elektrowizards/Virtueller_Sicherheitsbereich_fuer_Fahrradfahrer/bild/offset_3.jpeg

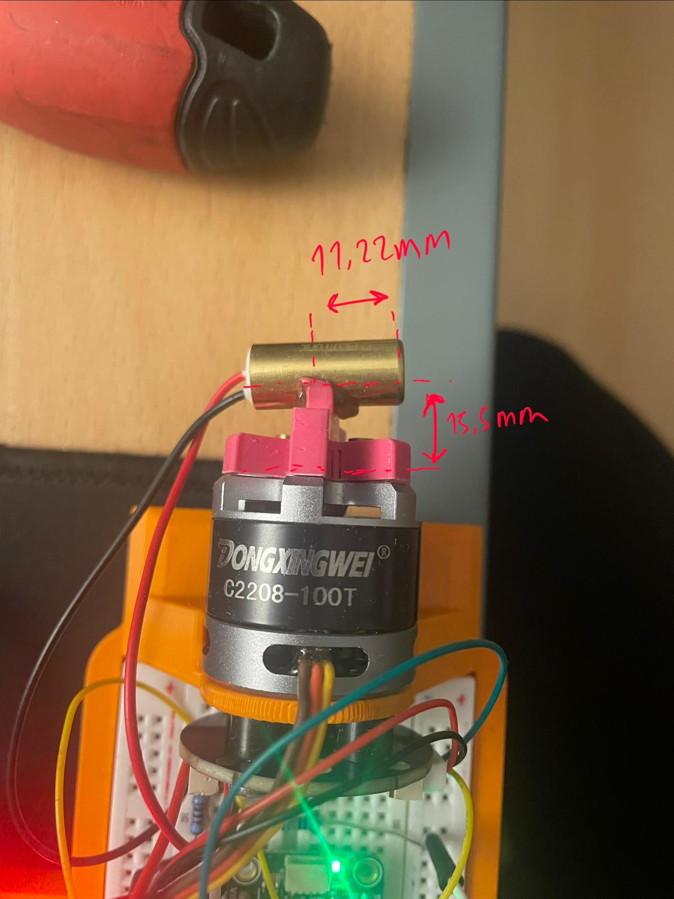
bild/offset_3.jpeg
