elektrowizards/Virtueller_Sicherheitsbereich_fuer_Fahrradfahrer/bild/offset_2.jpeg

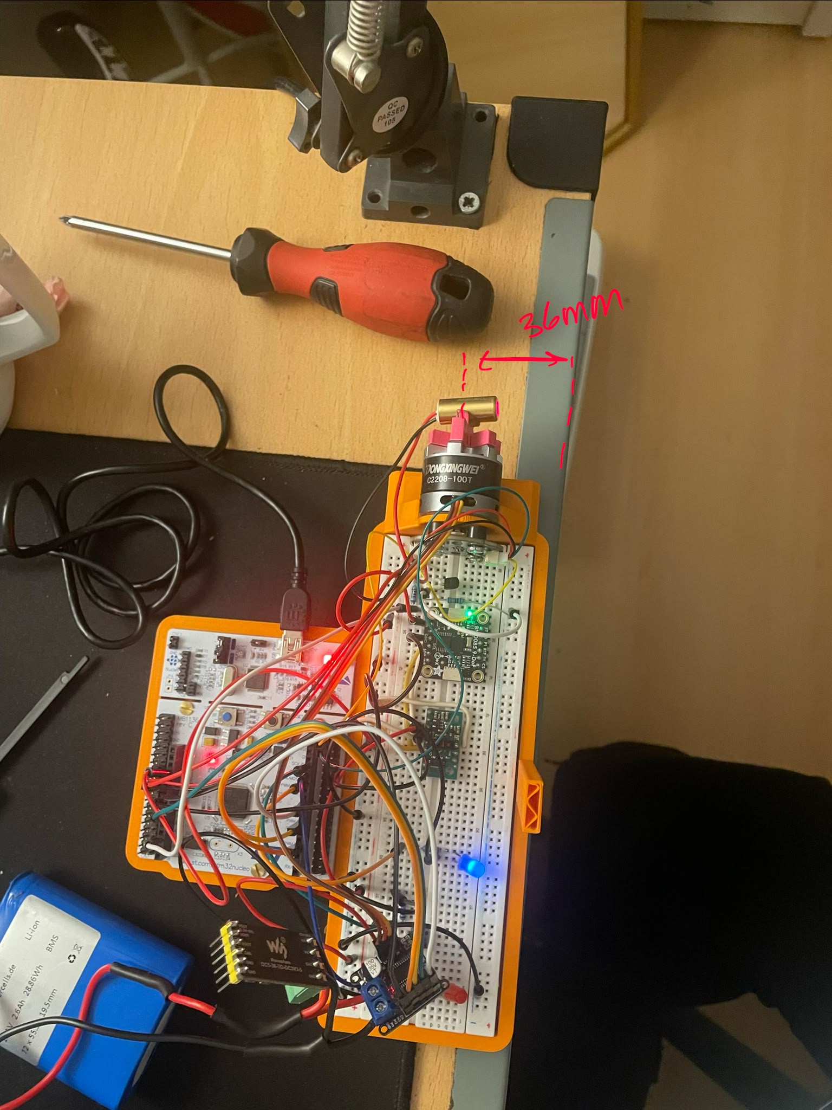
bild/offset_2.jpeg
