elektrowizards/Virtueller_Sicherheitsbereich_fuer_Fahrradfahrer/bild/offset_1.jpeg

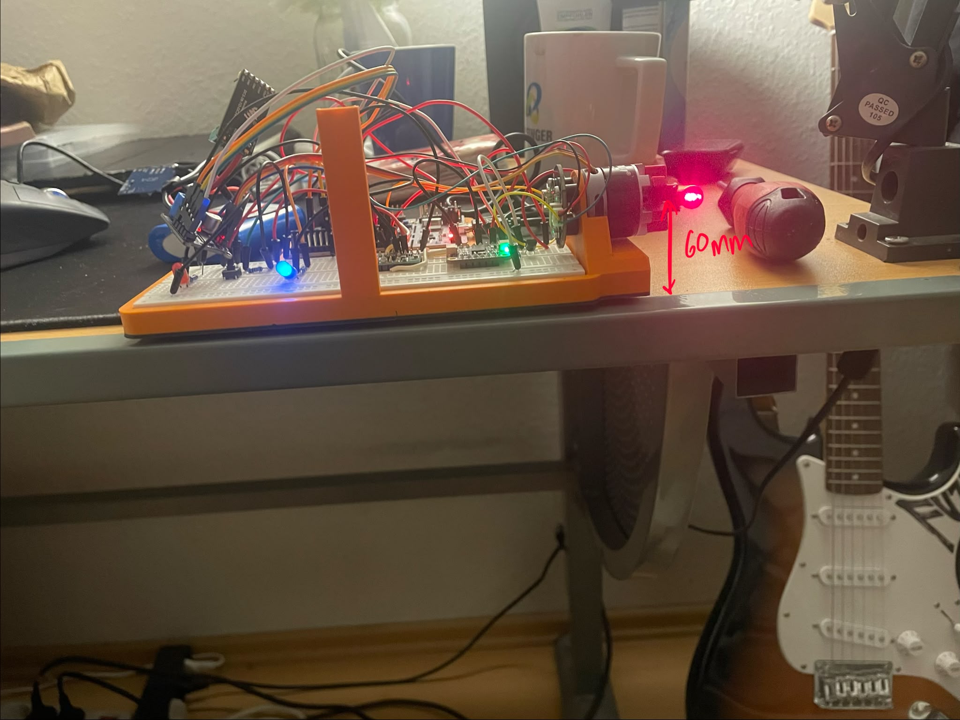
bild/offset_1.jpeg
