elektrowizards/Virtueller_Sicherheitsbereich_fuer_Fahrradfahrer/3D_design/gehäuse_board.FCStd

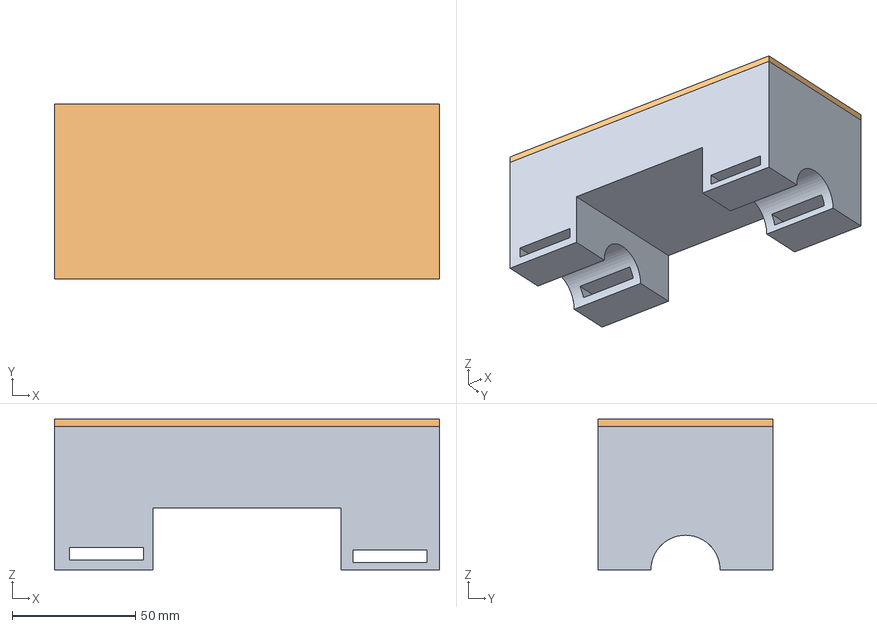
[picture p4: CAD file, 2026-11-11]
3D_design/gehäuse_board.FCStd
156.0 x 71.0 x 61.0 mm
main
tutup
