elektrowizards/Virtueller_Sicherheitsbereich_fuer_Fahrradfahrer/firmware_BA-testing_with laser driver/3D_design/Gehäuse-Body.3mf

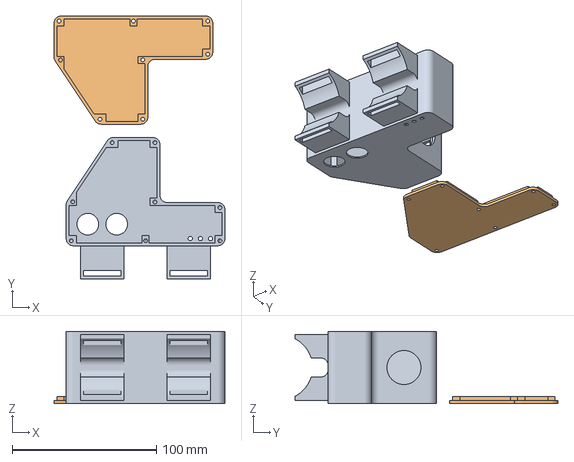
[picture p5: CAD file, 2026-11-11]
firmware_BA-testing_with laser driver/3D_design/Gehäuse-Body.3mf
118.4 x 182.2 x 50.0 mm
Gehäuse-Body
Gehäuse-cap
