elektrowizards/Virtueller_Sicherheitsbereich_fuer_Fahrradfahrer/firmware_BA-testing_with laser driver/hardware/SimpleFOCMini-1.0/3D model/OBJ_simplefocmini.obj

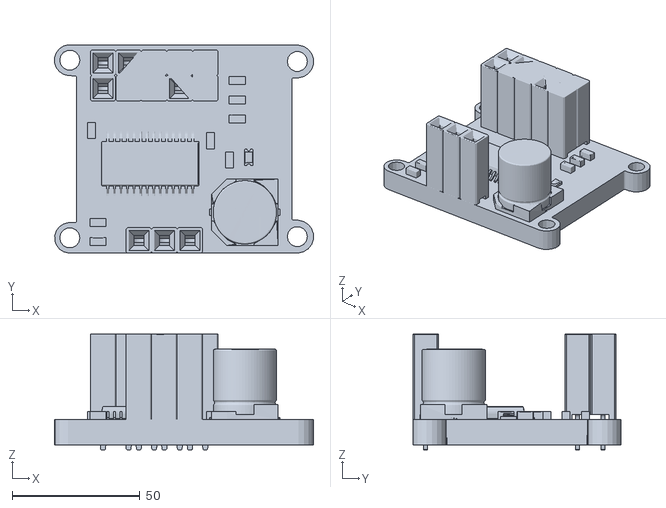
[picture p6: CAD file, 2026-11-11]
firmware_BA-testing_with laser driver/hardware/SimpleFOCMini-1.0/3D model/OBJ_simplefocmini.obj
101.3 x 81.5 x 45.3
