elektrowizards/Virtueller_Sicherheitsbereich_fuer_Fahrradfahrer/PCB_design/PCB_STM32_custom_board/final_pcb_design/board.step

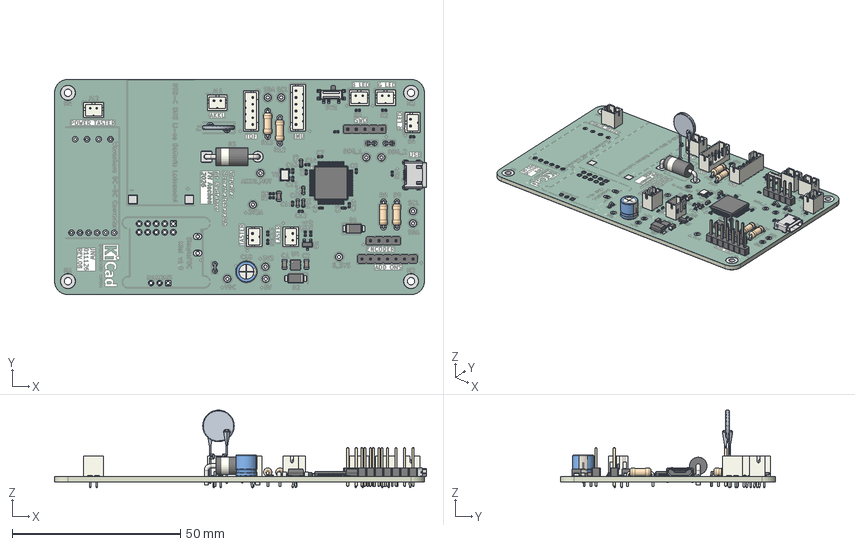
[picture p7: CAD file, 2026-11-11]
PCB_design/PCB_STM32_custom_board/final_pcb_design/board.step
110.6 x 64.0 x 23.1 mm
JST_B2B_PH_K x 7
C_0402_1005Metric x 12
PinHeader_1x07_P254mm_Vertical
R_0402_1005Metric x 10
JST_B6B_PH_K
TestPoint_Bridge_Pitch2.0mm_Drill0.7mm x 3
R_Axial_DIN0207_L63mm_D25mm_P762mm_Horizontal x 4
C_0805_2012Metric x 3
DFN_6_1EP_3x3mm_Pitch1mm
C_0603_1608Metric x 3
629105150521_Housing
629105150521_Pin1 x 4
629105150521_Pin2
629105150521_Shielding2
629105150521_Shielding
MF-RHT200
PinHeader_1x05_P254mm_Vertical
D_DO-201AD_P15.24mm_Horizontal
Fusion_sp
Crystal_SMD_3225-4Pin_3.2x2.5mm
L_0603_1608Metric
CP_Radial_D63mm_P250mm
D_SMA x 2
SOT-23
PinHeader_1x04_P254mm_Vertical
LQFP-64_10x10mm_P0.5mm
JST_B5B_PH_K
PCB_STM32_custom_board_copper
PCB_STM32_custom_board_pad
PCB_STM32_custom_board_via
PCB_STM32_custom_board_silkscreen x 2
PCB_STM32_custom_board_soldermask x 2
PCB_STM32_custom_board_PCB
