elektrowizards/Virtueller_Sicherheitsbereich_fuer_Fahrradfahrer/firmware_BA-testing_with laser driver/3D_design/bracket_BLDC_motor_zumPrototype-Body.3mf

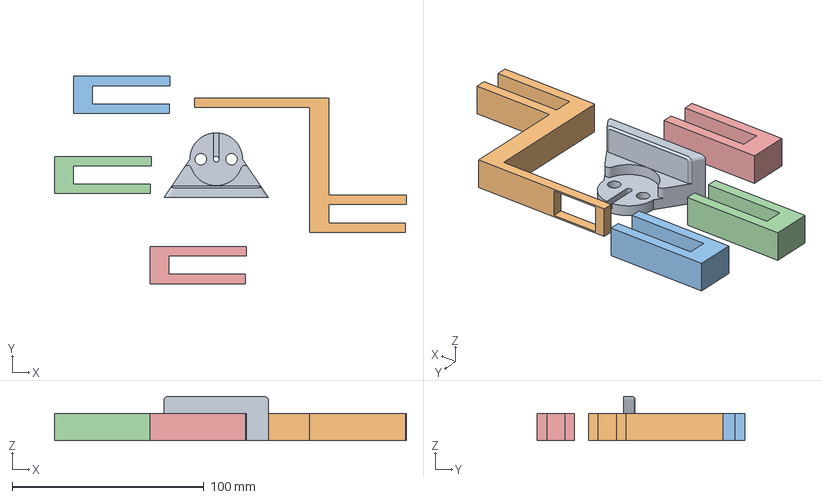
[picture p8: CAD file, 2026-11-11]
firmware_BA-testing_with laser driver/3D_design/bracket_BLDC_motor_zumPrototype-Body.3mf
183.4 x 108.1 x 23.0 mm
bracket_BLDC_motor_zumPrototype-Body
ständer_ToF_sensor-ständer_groß
ständer_ToF_sensor-ständer_klein x 3
