elektrowizards/Virtueller_Sicherheitsbereich_fuer_Fahrradfahrer/firmware_BA-testing_with laser driver/PCB_design/footprints/WE_629105150521_CAD_files/Download_IGES_629105150521 (rev1).iges

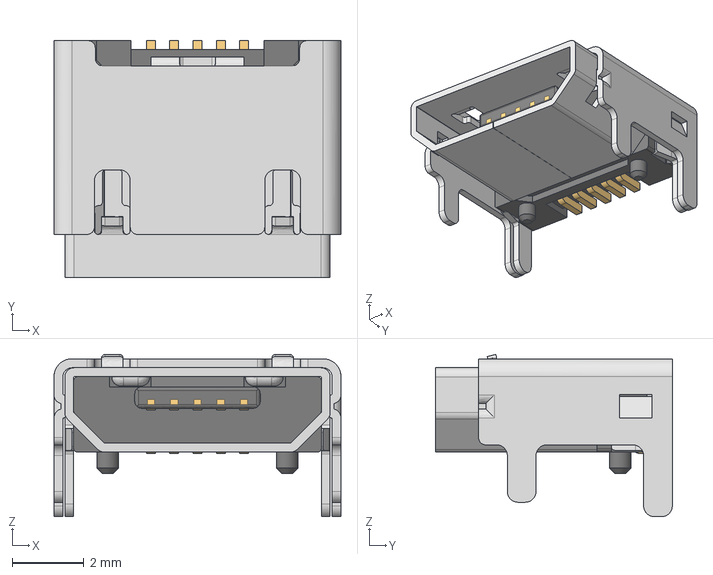
[picture p9: CAD file, 2026-11-11]
firmware_BA-testing_with laser driver/PCB_design/footprints/WE_629105150521_CAD_files/Download_IGES_629105150521 (rev1).iges
8.00 x 6.60 x 4.52 mm
