elektrowizards/Virtueller_Sicherheitsbereich_fuer_Fahrradfahrer/firmware_BA-testing_with laser driver/3D_design/ständer_ToF_sensor-ständer_groß.3mf

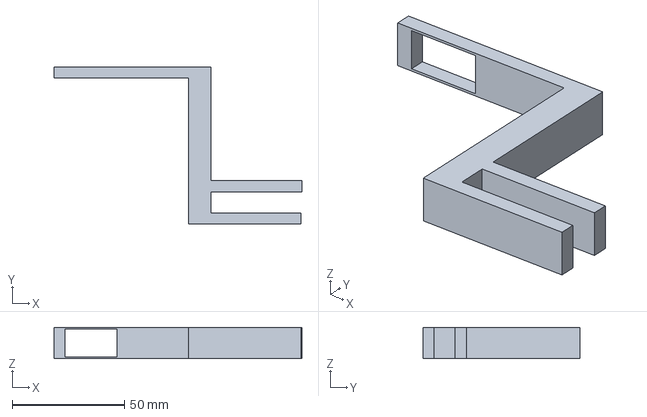
[picture p10: CAD file, 2026-11-11]
firmware_BA-testing_with laser driver/3D_design/ständer_ToF_sensor-ständer_groß.3mf
110.5 x 70.0 x 14.0 mm
