elektrowizards/Virtueller_Sicherheitsbereich_fuer_Fahrradfahrer/firmware_BA-testing_with laser driver/3D_design/ständer_ToF_sensor-ständer_klein.3mf

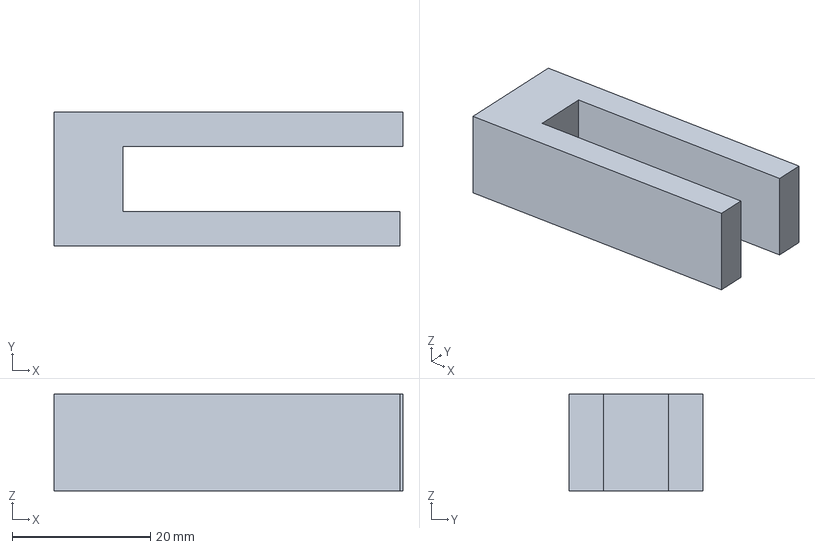
[picture p11: CAD file, 2026-11-11]
firmware_BA-testing_with laser driver/3D_design/ständer_ToF_sensor-ständer_klein.3mf
50.5 x 19.4 x 14.0 mm
