elektrowizards/Virtueller_Sicherheitsbereich_fuer_Fahrradfahrer/firmware_BA-testing_with laser driver/3D_design/Gehäuse-cap.3mf

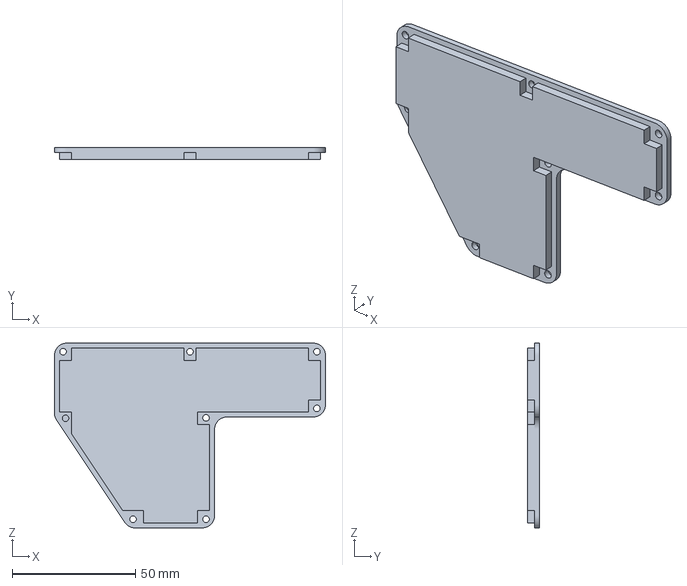
[picture p12: CAD file, 2026-11-11]
firmware_BA-testing_with laser driver/3D_design/Gehäuse-cap.3mf
110.0 x 5.00 x 75.0 mm
