elektrowizards/Virtueller_Sicherheitsbereich_fuer_Fahrradfahrer/(list of files, cad)

Other CAD files:
firmware_BA-testing_with laser driver/PCB_design/footprints/WE_629105150521_CAD_files/629105150521 (rev1).stp
