elektrowizards/Virtueller_Sicherheitsbereich_fuer_Fahrradfahrer/firmware_BA-testing_with laser driver/PCB_design/aufbau_schematic_main/kiCAD_Bachelorarbeit.pdf

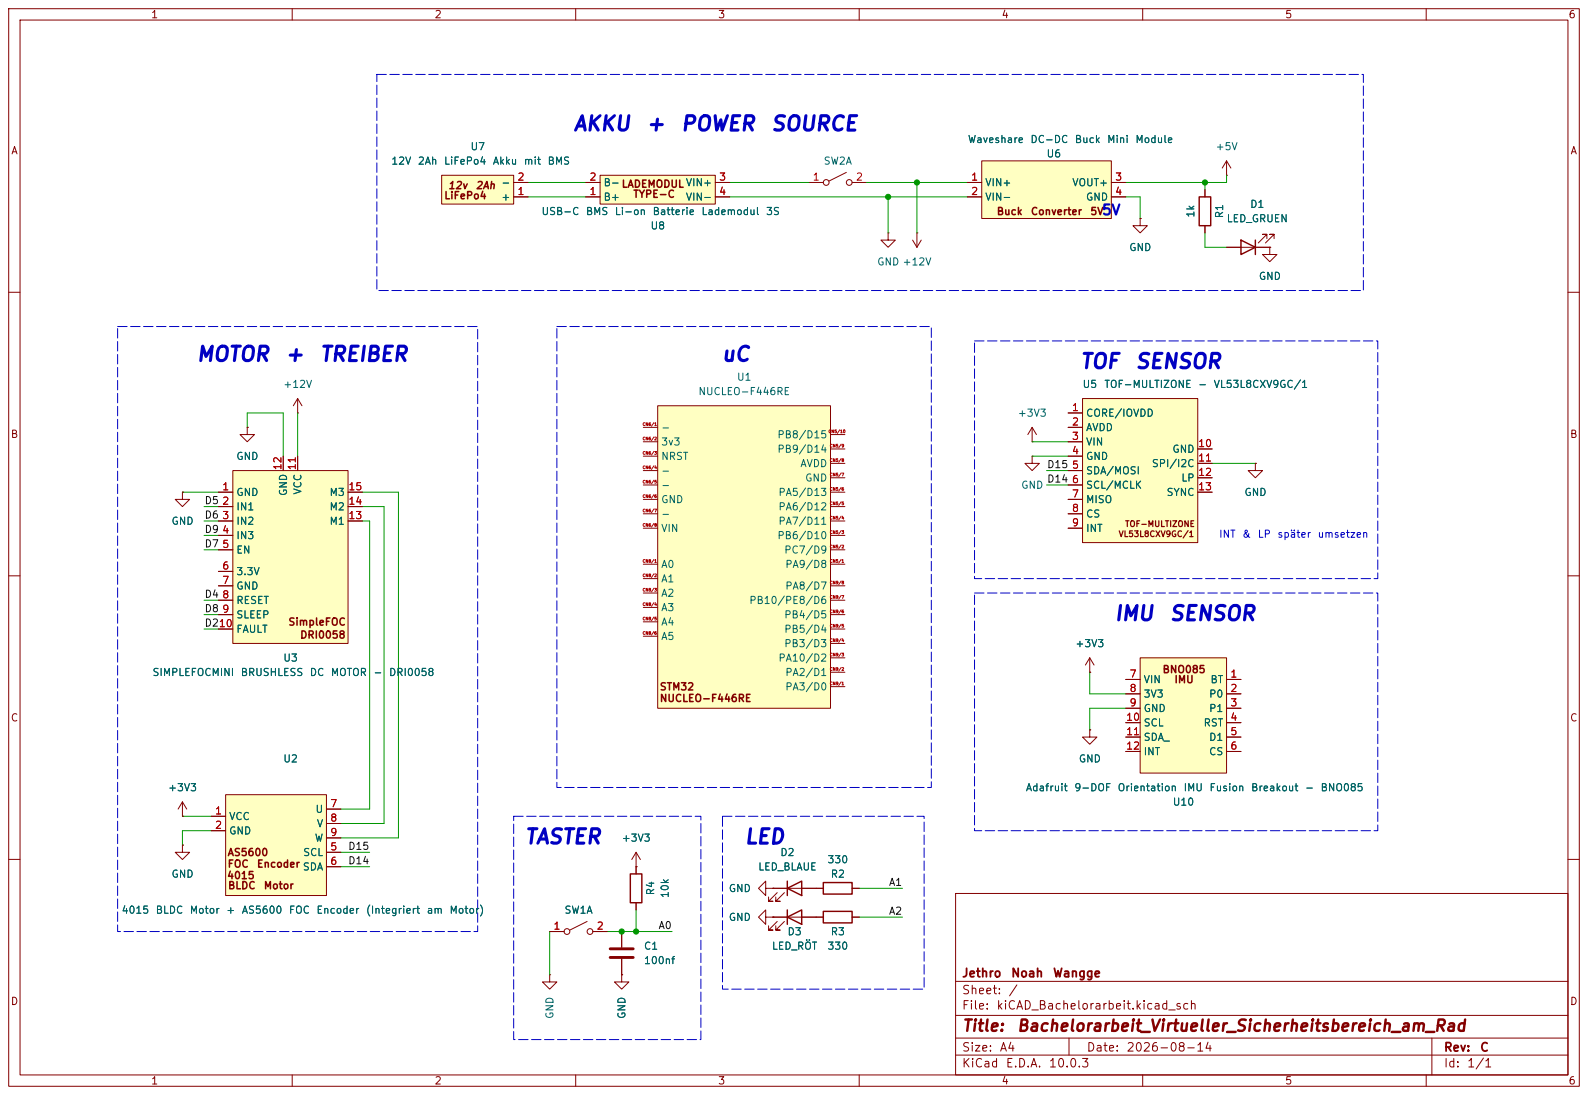
[picture p13: page 1]

12V 2Ah LiFePo4 Akku mit BMS GND

INT & LP später umsetzen MOTOR + TREIBER

SYNC 13 U5 TOF-MULTIZONE - VL53L8CXV9GC/1 +3V3 GND

TOF-MULTIZONE CORE/IOVDD 1
AVDD 2

Size: A4 | Rev: C
KiCad E.D.A. 10.0.3 | Id: 1/1
