elektrowizards/Virtueller_Sicherheitsbereich_fuer_Fahrradfahrer/firmware_BA-testing_with laser driver/PCB_design/plot_schematics/PCB_STM32_custom_board_v4.5_perfected.pdf

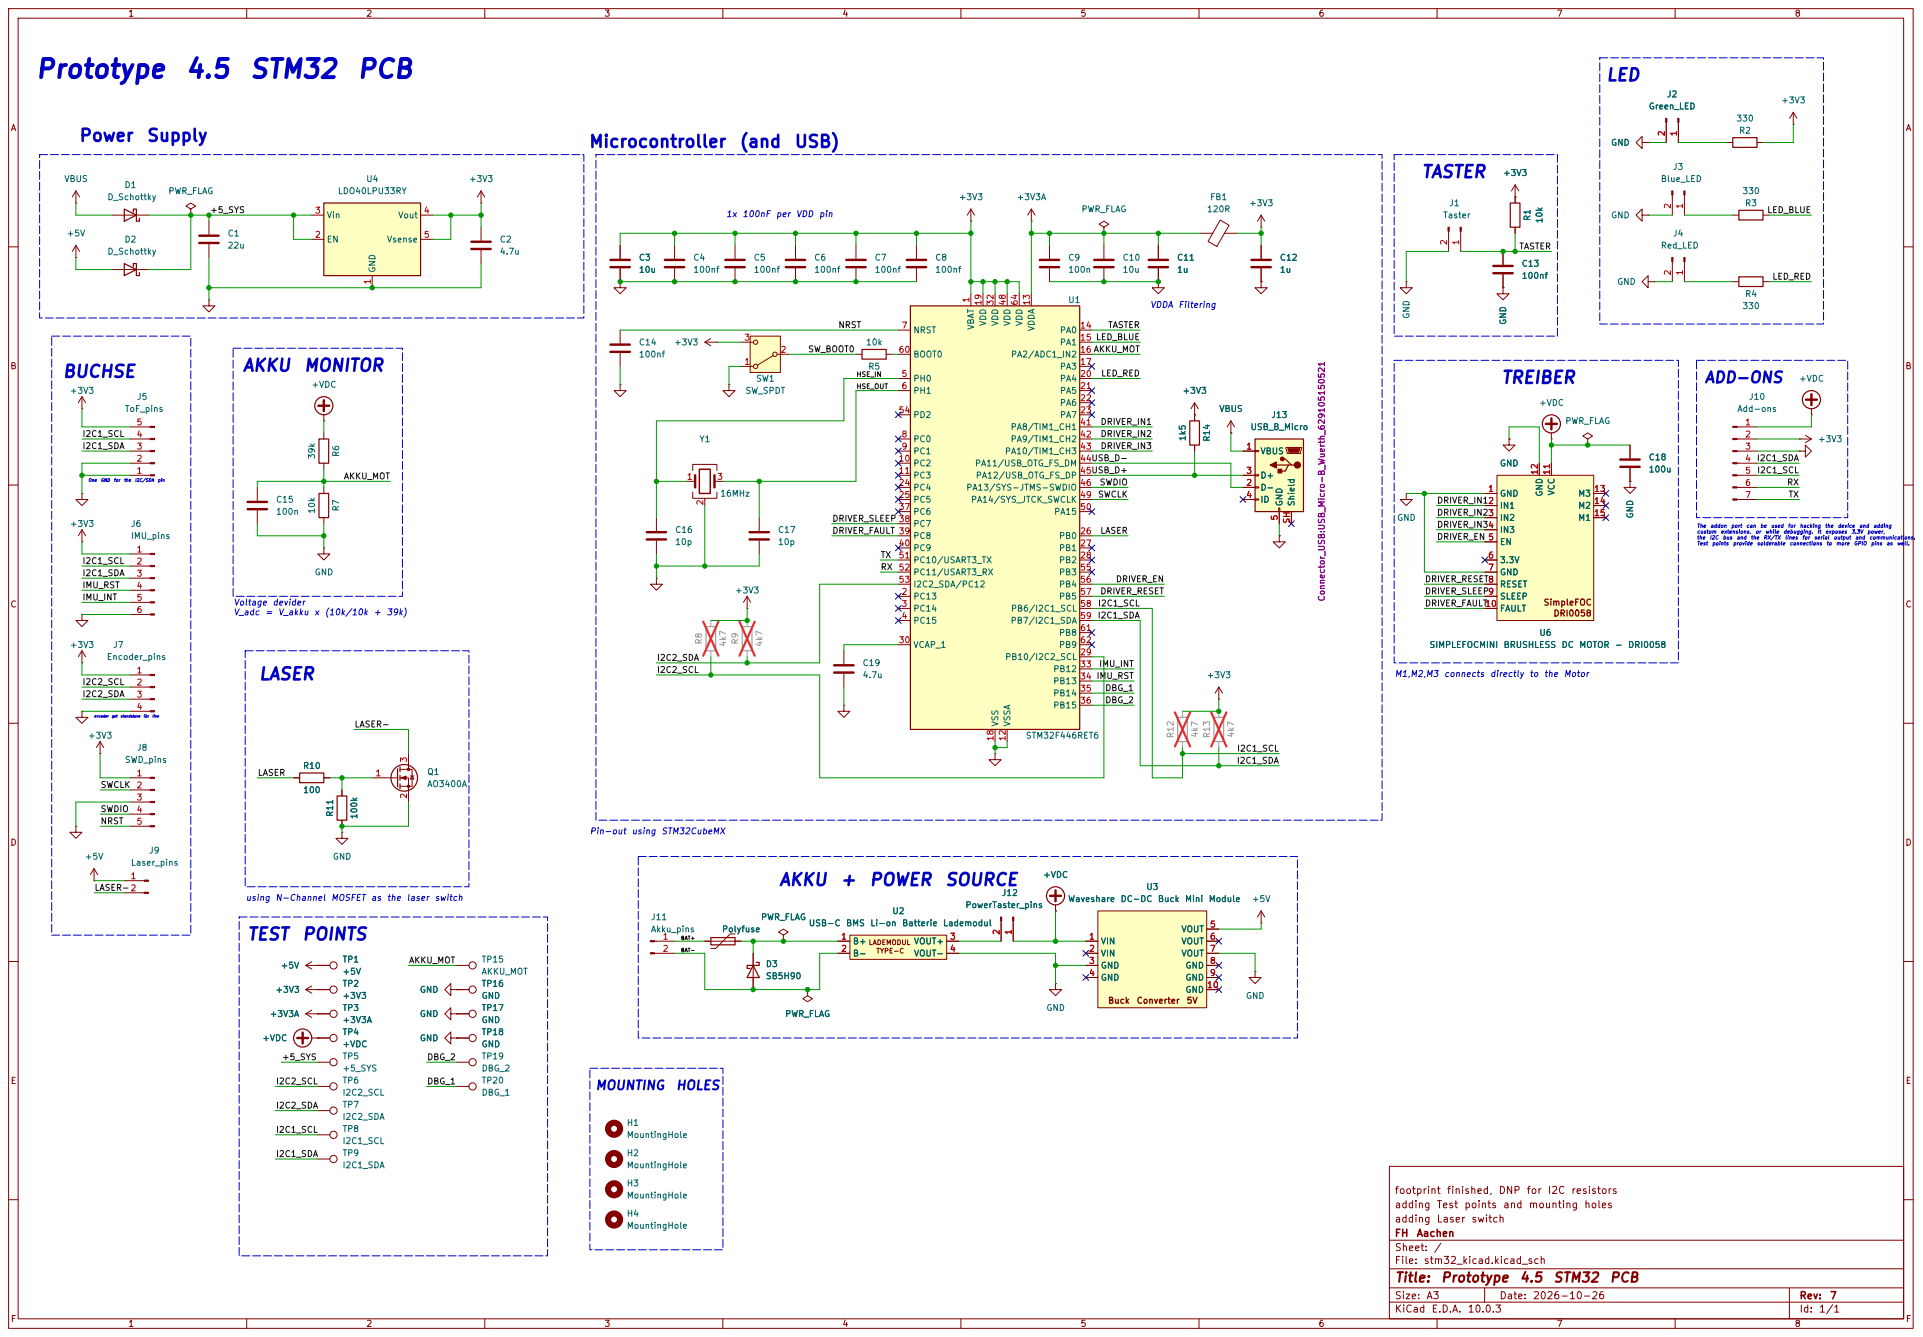
[picture p14: page 1]

Pin-out using STM32CubeMX Power Supply

SIMPLEFOCMINI BRUSHLESS DC MOTOR - DRI0058 GND

Test points provide solderable connections to more GPIO pins as well. BUCHSE

SIMPLEFOCMINI BRUSHLESS DC MOTOR - DRI0058 GND 1

The addon port can be used for hacking the device and adding custom extensions, or while debugging. It exposes 3.3V power,

the I2C bus and the RX/TX lines for serial output and communications.

using N-Channel MOSFET as the laser switch TEST POINTS

adding Test points and mounting holes
FH Aachen adding Laser switch

File: stm32_kicad.kicad_sch Sheet: /
Id: 1/1 Title: Prototype 4.5 STM32 PCB

Size: A3 | Rev: 7
F Date: 2026-10-26 KiCad E.D.A. 10.0.3
