elektrowizards/Virtueller_Sicherheitsbereich_fuer_Fahrradfahrer/firmware_BA-testing_with laser driver/PCB_design/plot_schematics/PCB_STM32_custom_board_v5.pdf

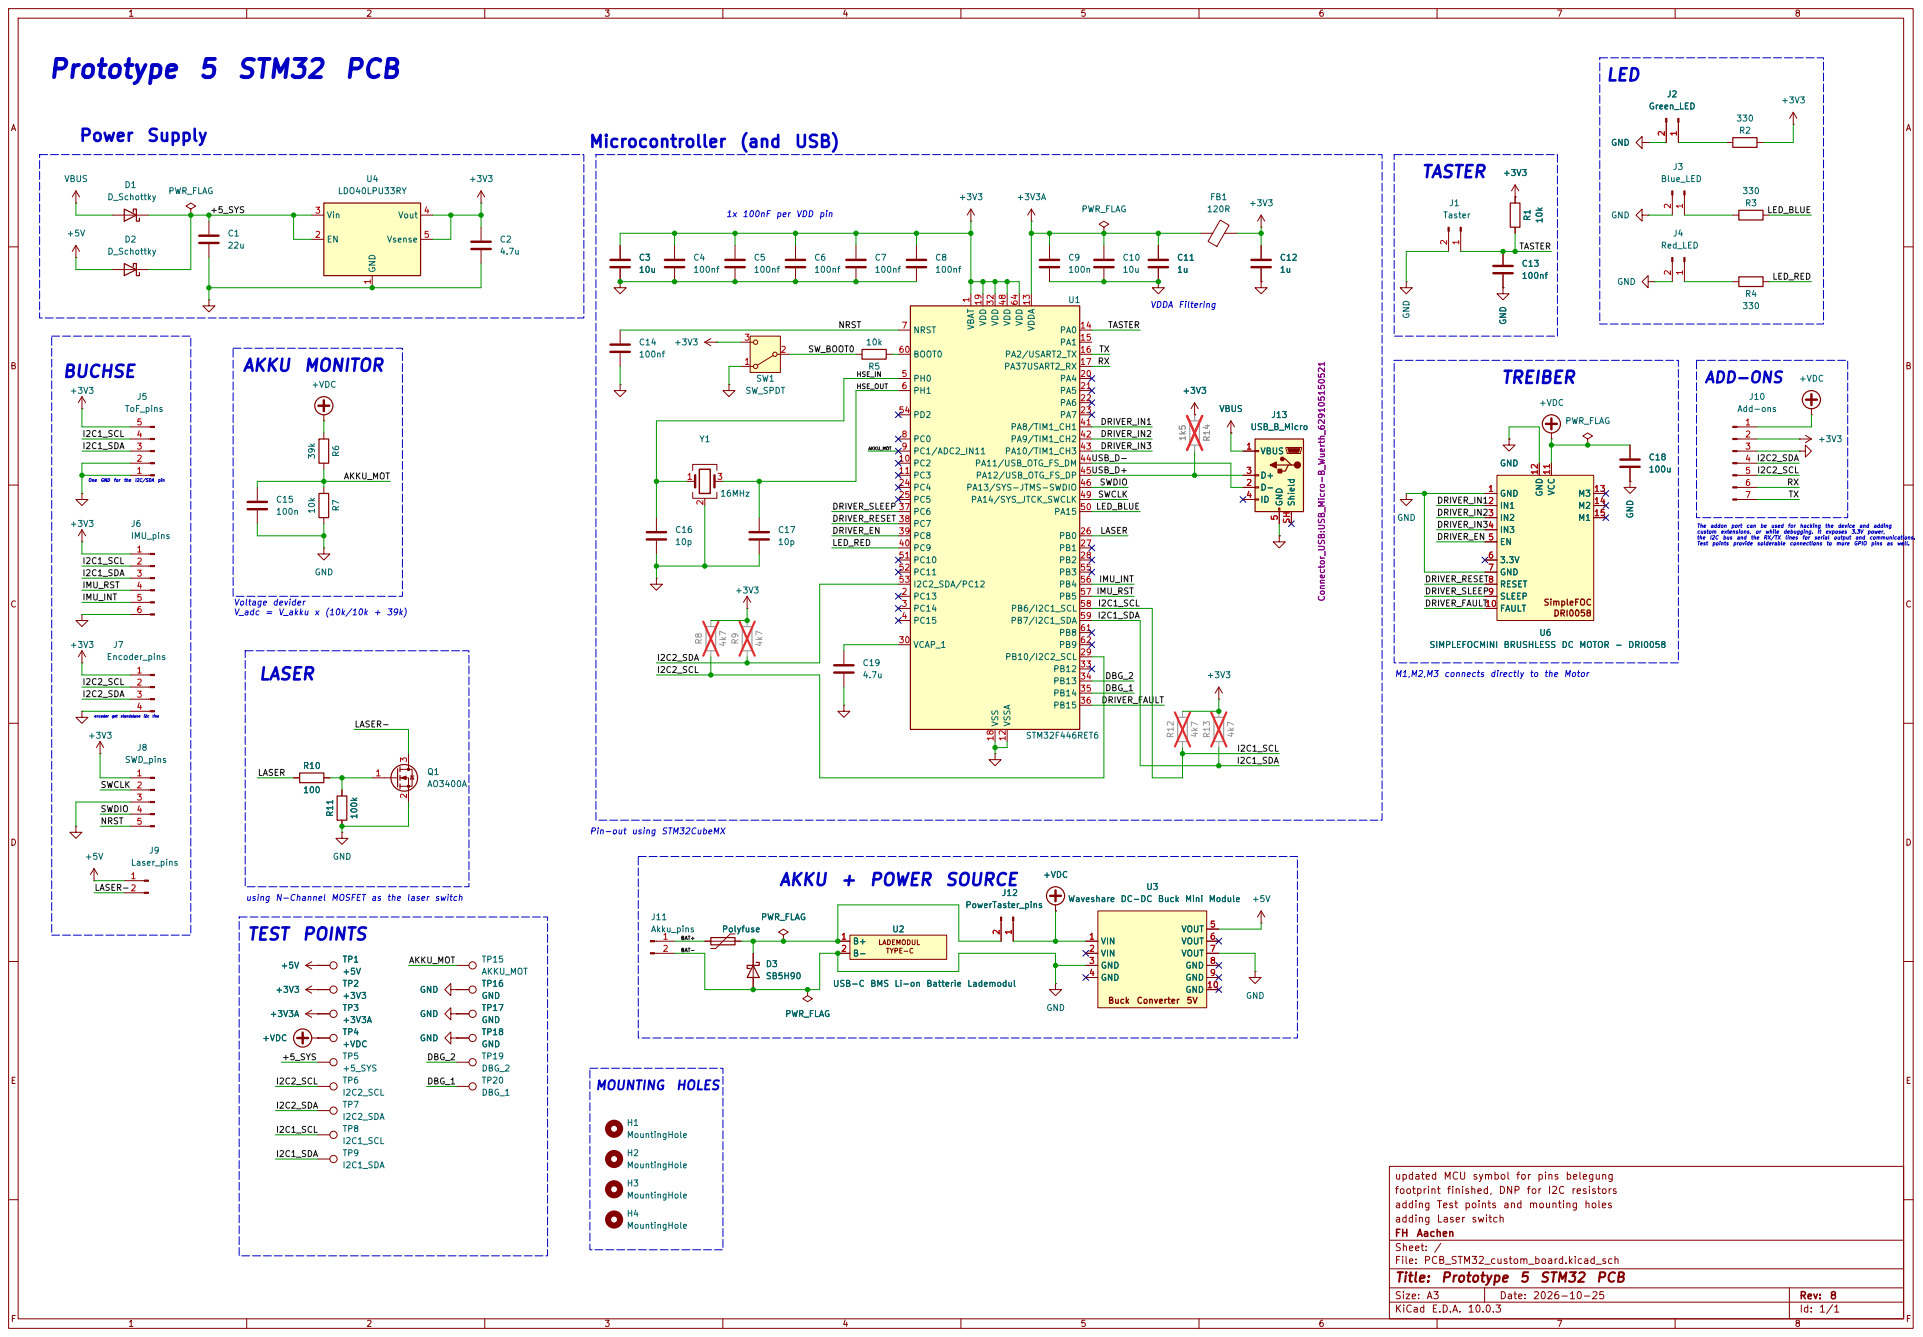
[picture p15: page 1]

VDDA Filtering Prototype 5 STM32 PCB

TASTER

Voltage devider V_adc = V_akku x (10k/10k + 39k) AKKU MONITOR

Test points provide solderable connections to more GPIO pins as well. M1,M2,M3 connects directly to the Motor TREIBER

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

the I2C bus and the RX/TX lines for serial output and communications.

SIMPLEFOCMINI BRUSHLESS DC MOTOR - DRI0058

using N-Channel MOSFET as the laser switch LASER

footprint finished, DNP for I2C resistors updated MCU symbol for pins belegung

adding Test points and mounting holes
FH Aachen adding Laser switch

Id: 1/1 Title: Prototype 5 STM32 PCB

Size: A3 | Rev: 8
F Date: 2026-10-25 KiCad E.D.A. 10.0.3
