elektrowizards/Virtueller_Sicherheitsbereich_fuer_Fahrradfahrer/firmware_BA-testing_with laser driver/PCB_design/output.pdf

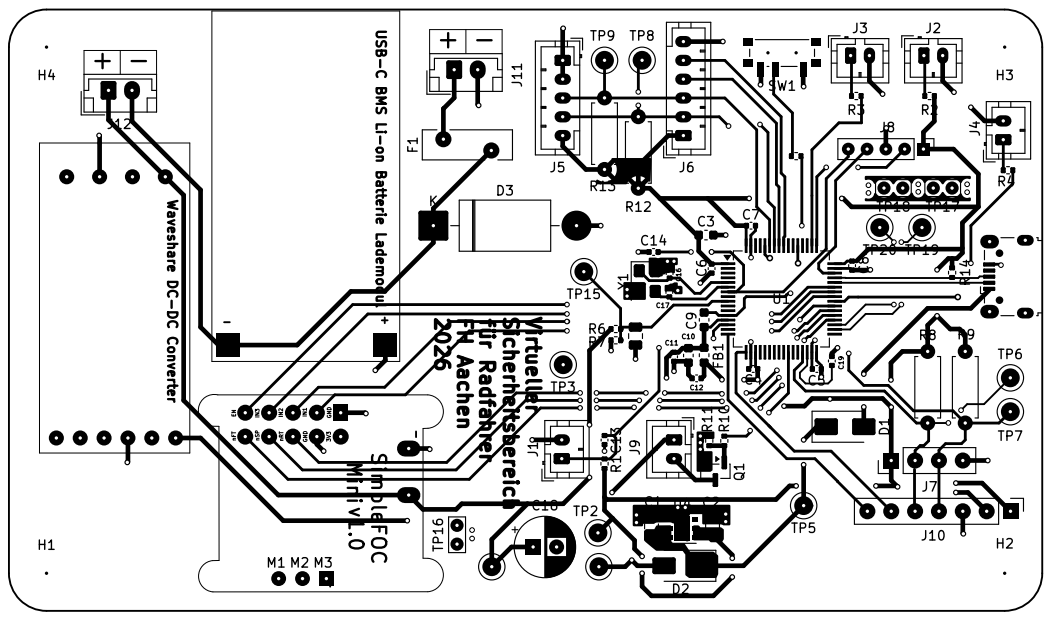
[picture p16: page 1]
