elektrowizards/Virtueller_Sicherheitsbereich_fuer_Fahrradfahrer/firmware_BA-testing_with laser driver/PCB_design/plot_schematics/PCB_STM32_custom_board_v2.5.pdf

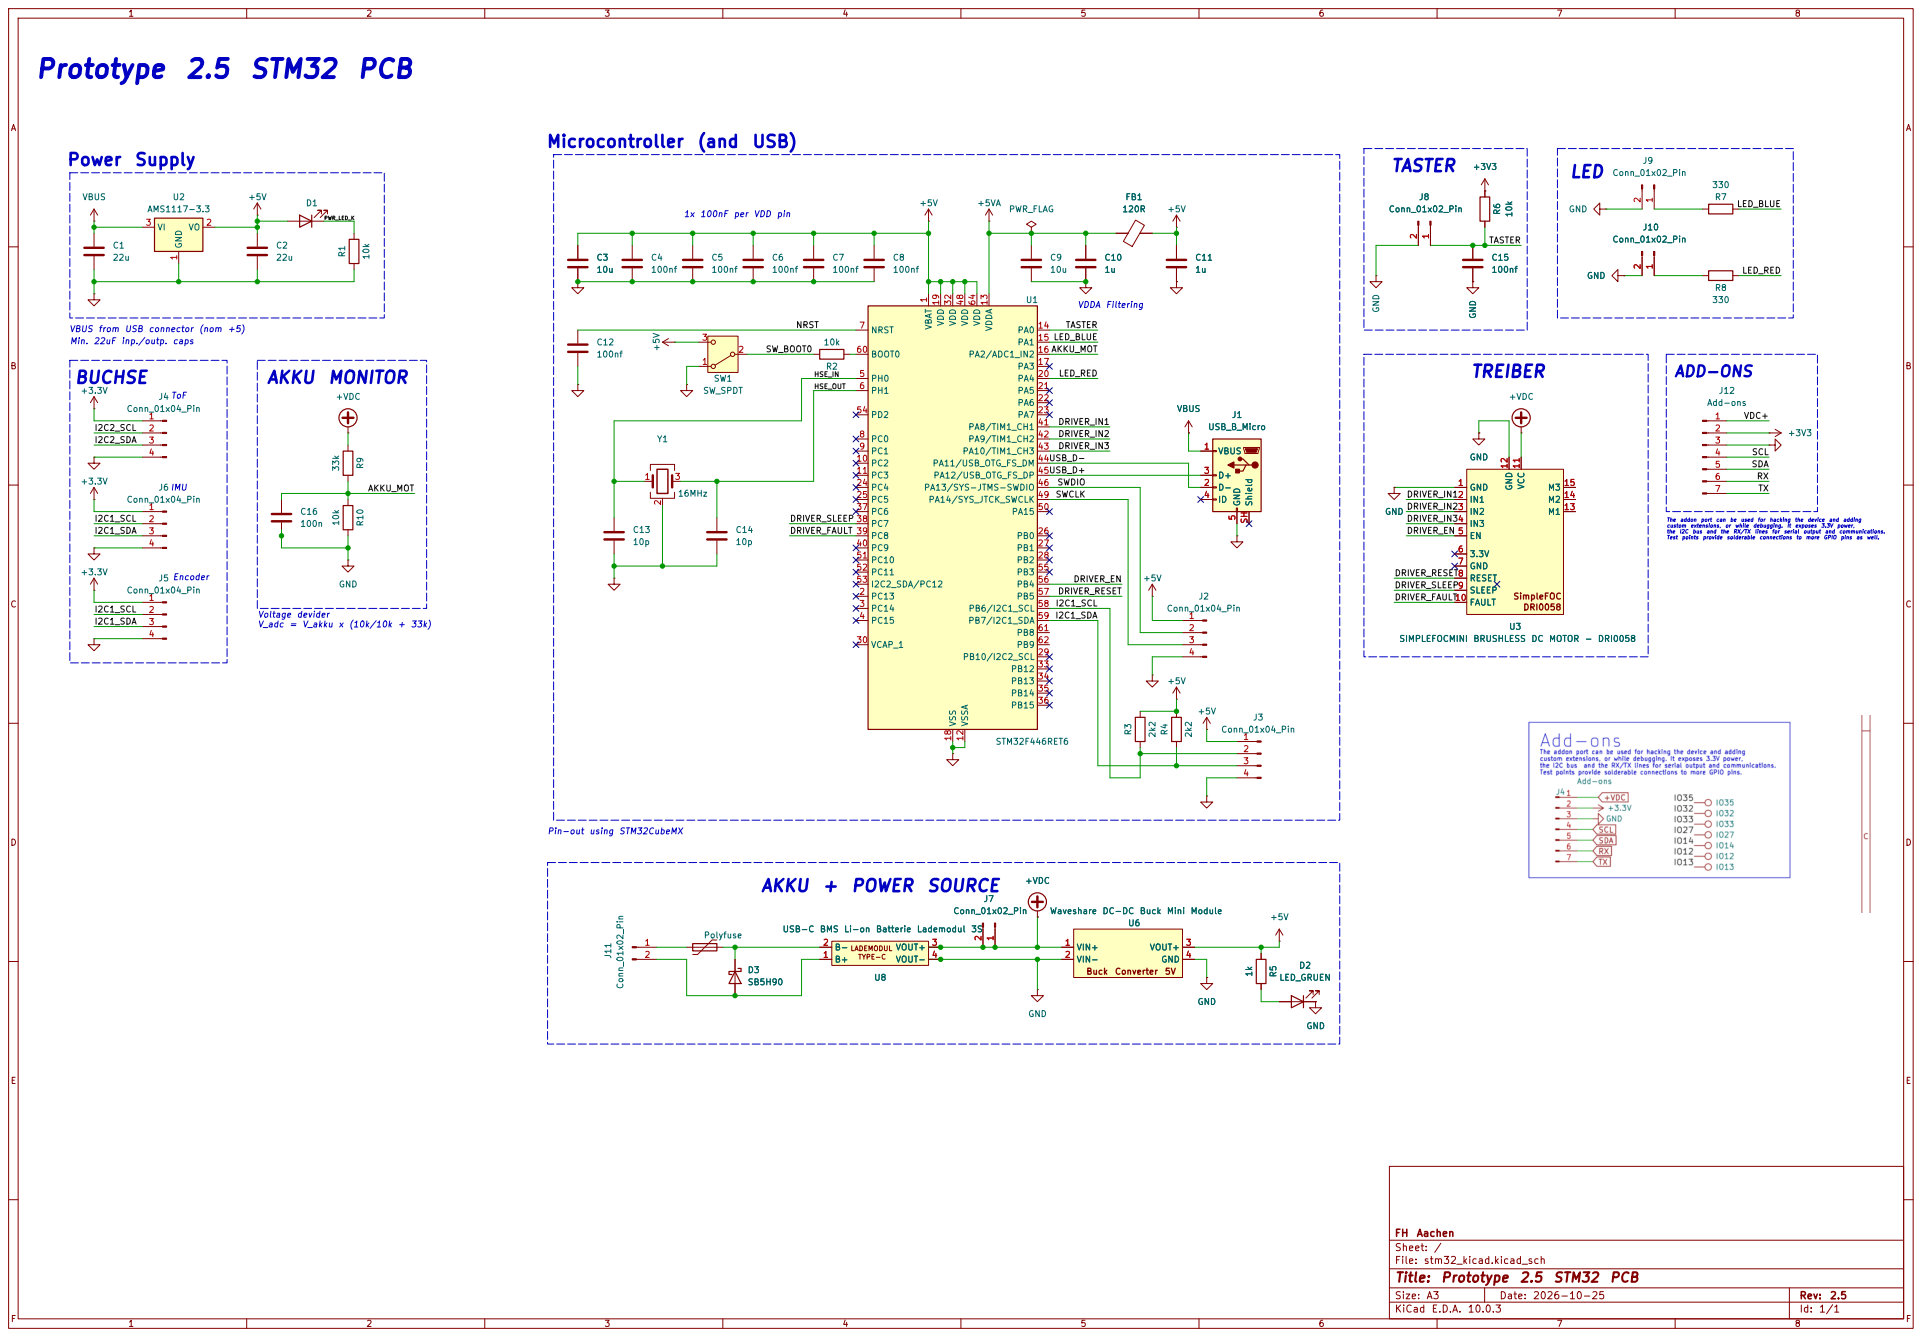
[picture p23: page 1]

Test points provide solderable connections to more GPIO pins as well. Encoder Prototype 2.5 STM32 PCB

SIMPLEFOCMINI BRUSHLESS DC MOTOR - DRI0058 +VDC
FAULT 10 GND

SIMPLEFOCMINI BRUSHLESS DC MOTOR - DRI0058 GND 1
DRIVER_IN1 DRIVER_IN2 DRIVER_RESET

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

the I2C bus and the RX/TX lines for serial output and communications.

U6 Waveshare DC-DC Buck Mini Module

Id: 1/1 Title: Prototype 2.5 STM32 PCB

Size: A3 | Rev: 2.5
F Date: 2026-10-25 KiCad E.D.A. 10.0.3
