elektrowizards/Virtueller_Sicherheitsbereich_fuer_Fahrradfahrer/firmware_BA-testing_with laser driver/PCB_design/plot_schematics/PCB_STM32_custom_board_v4.pdf

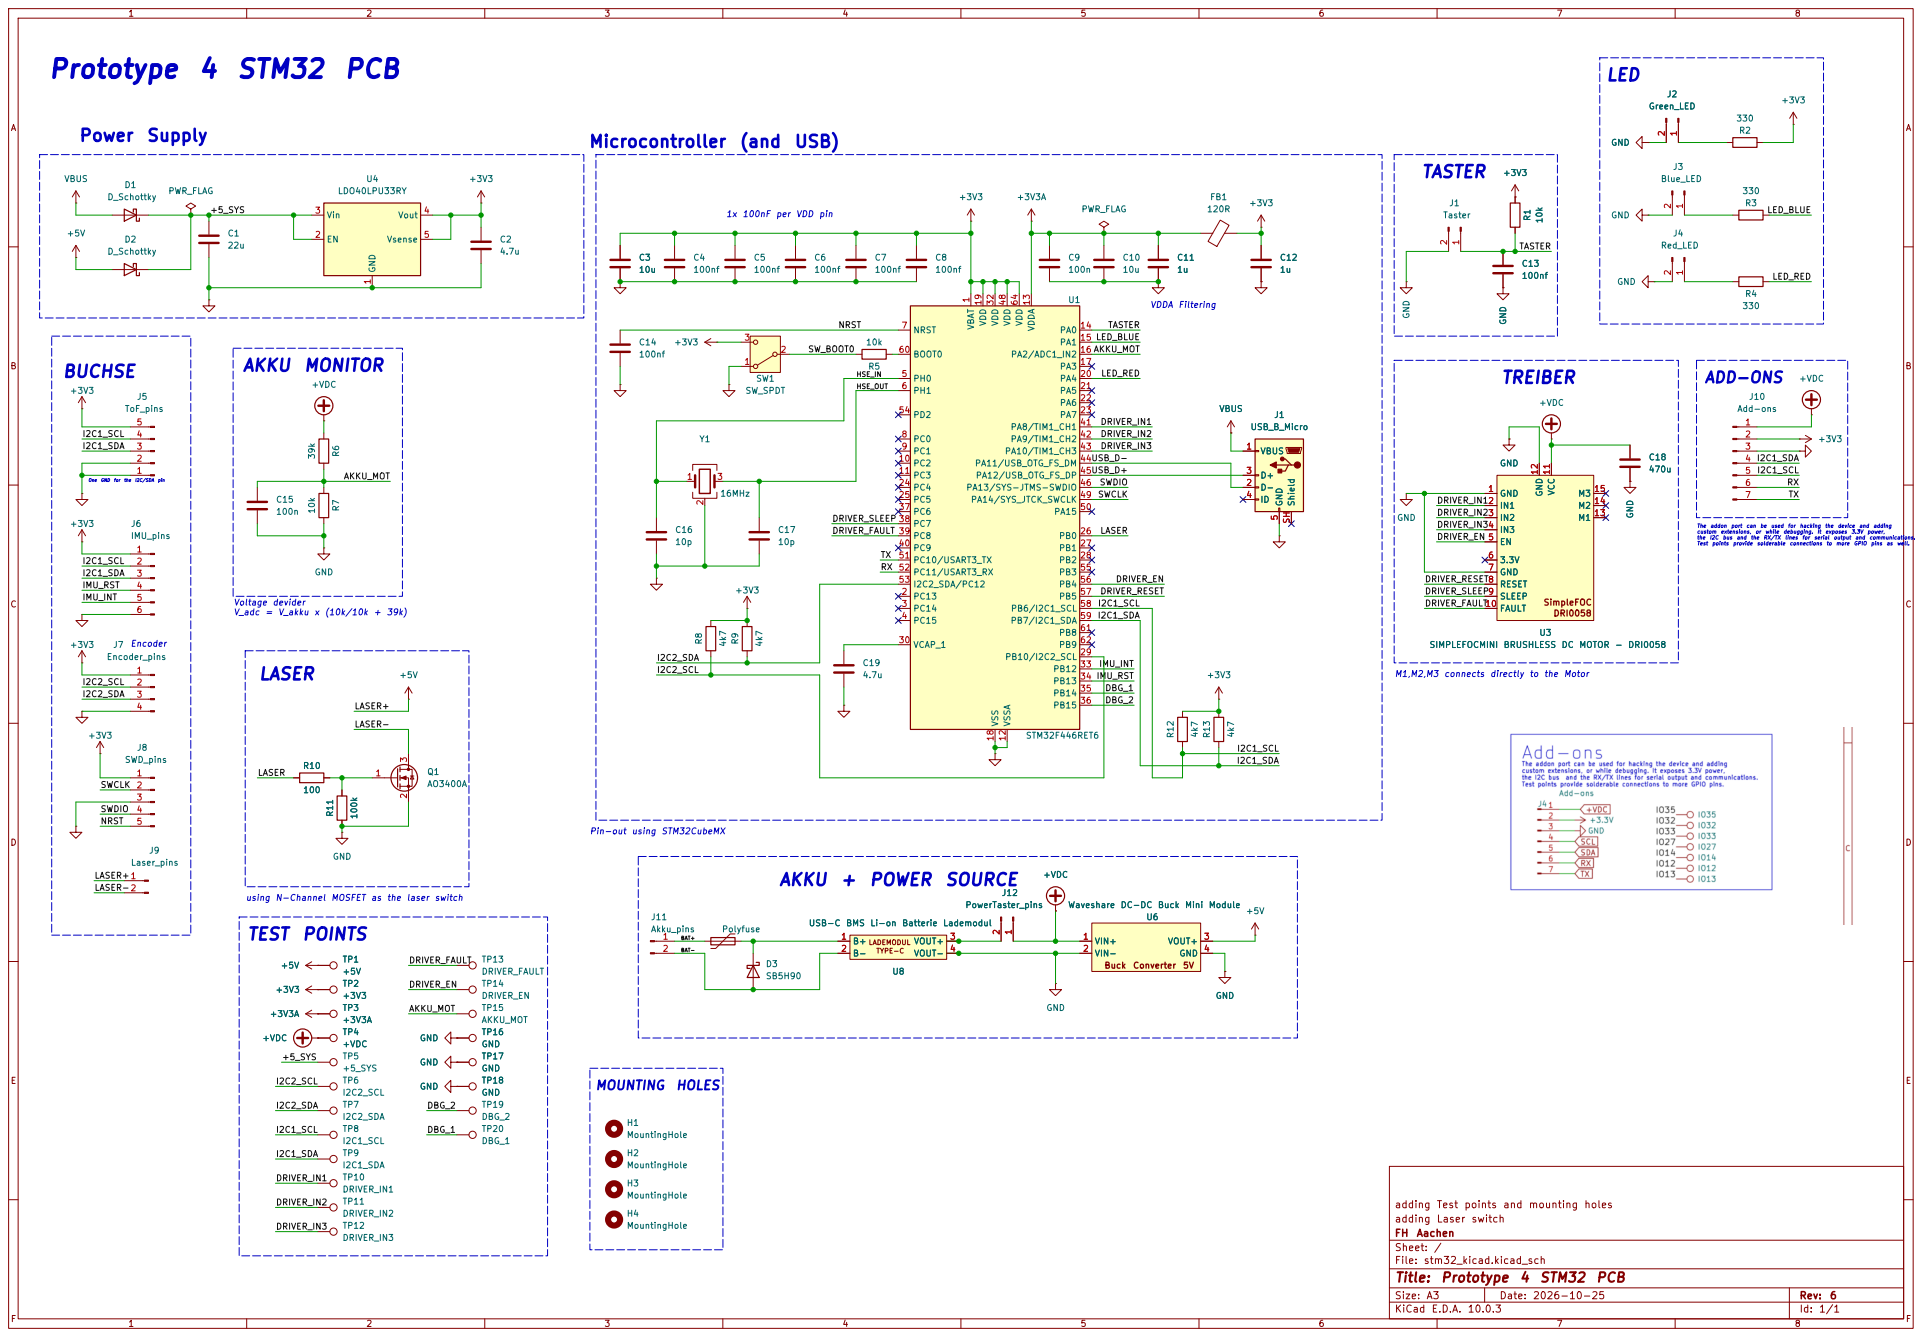
[picture p24: page 1]

1x 100nF per VDD pin Microcontroller (and USB)

VDDA Filtering AKKU + POWER SOURCE

Test points provide solderable connections to more GPIO pins as well. TREIBER AKKU MONITOR

SIMPLEFOCMINI BRUSHLESS DC MOTOR - DRI0058 +VDC

SIMPLEFOCMINI BRUSHLESS DC MOTOR - DRI0058 GND 1

the I2C bus and the RX/TX lines for serial output and communications.

M1,M2,M3 connects directly to the Motor

using N-Channel MOSFET as the laser switch
TEST POINTS

1 U6 Waveshare DC-DC Buck Mini Module

adding Test points and mounting holes GND

FH Aachen adding Laser switch

File: stm32_kicad.kicad_sch Sheet: /
Id: 1/1 Title: Prototype 4 STM32 PCB

Size: A3 | Rev: 6
F Date: 2026-10-25 KiCad E.D.A. 10.0.3
