elektrowizards/Virtueller_Sicherheitsbereich_fuer_Fahrradfahrer/(list of files, drawings)

Other design files:
firmware_BA-testing_with laser driver/hardware/DC5-36-TO-DC3V3-5.PcbLib
firmware_BA-testing_with laser driver/hardware/SimpleFOCMini-1.0/Altium/simplefocmini_2022-04-20.pcbdoc
firmware_BA-testing_with laser driver/hardware/SimpleFOCMini-1.0/Altium/simplefocmini_2022-04-20.schdoc
firmware_BA-testing_with laser driver/hardware/SimpleFOCMini-1.0/EasyEDA/PCB_simplefocmini_2022-04-20.json
firmware_BA-testing_with laser driver/hardware/SimpleFOCMini-1.0/EasyEDA/SCH_simplefocmini_2022-04-20.json
firmware_BA-testing_with laser driver/PCB_design/footprints/SimpleFOCMini-1.0/Altium/simplefocmini_2022-04-20.pcbdoc
firmware_BA-testing_with laser driver/PCB_design/footprints/SimpleFOCMini-1.0/Altium/simplefocmini_2022-04-20.schdoc
firmware_BA-testing_with laser driver/PCB_design/footprints/SimpleFOCMini-1.0/EasyEDA/PCB_simplefocmini_2022-04-20.json
firmware_BA-testing_with laser driver/PCB_design/footprints/SimpleFOCMini-1.0/EasyEDA/SCH_simplefocmini_2022-04-20.json
