elektrowizards/Virtueller_Sicherheitsbereich_fuer_Fahrradfahrer/firmware_BA-testing_with laser driver/PCB_design/PCB_STM32_custom_board/PCB_STM32_custom_board.kicad_pcb

## KiCad design firmware_BA-testing_with laser driver/PCB_design/PCB_STM32_custom_board/PCB_STM32_custom_board.kicad_pcb (2026-11-01)

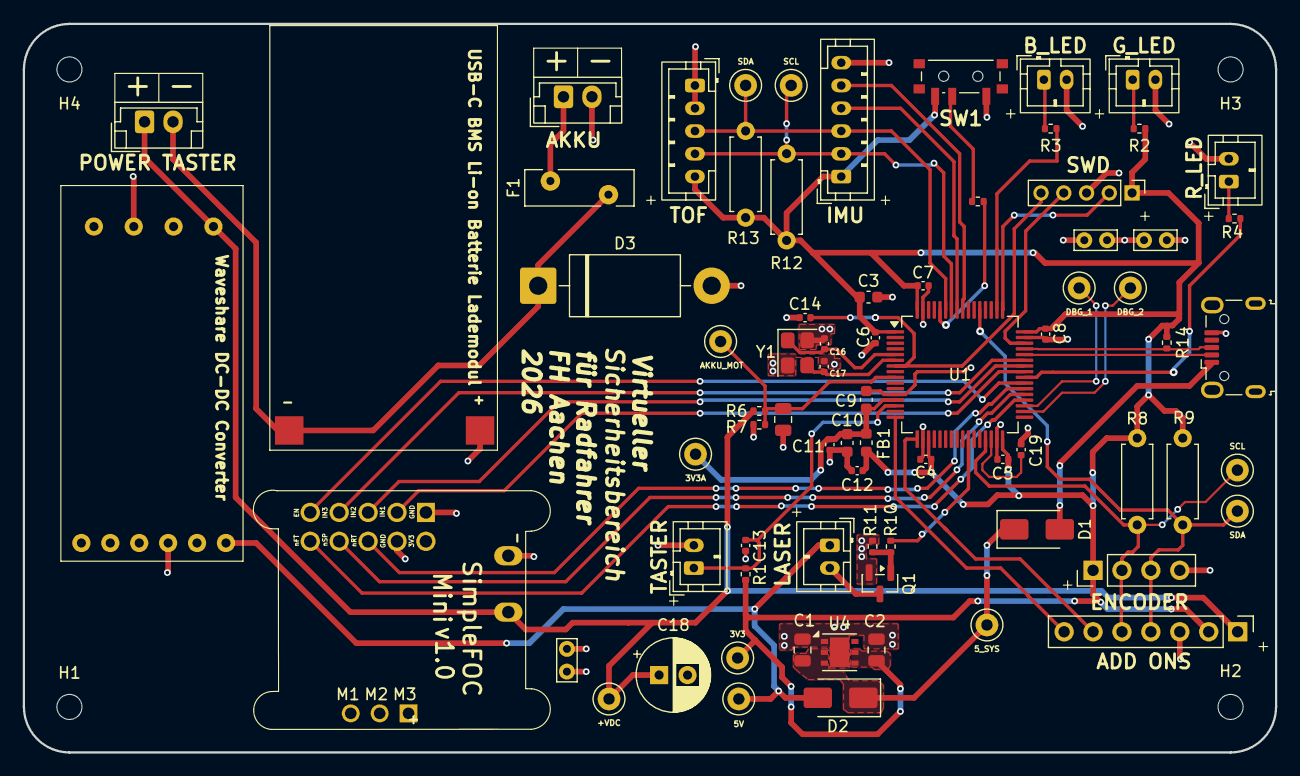
[picture p25: board PCB_STM32_custom_board.kicad_pcb from above]

Board: 2 copper layers, 110.0 x 64.0 mm, 78 parts (0 on the bottom side), 46 nets.

Parts:
3V3: +3V3; TestPoint_Keystone_5000-5004_Miniature
3V3A: +3V3A; TestPoint_Keystone_5000-5004_Miniature
5_SYS: +5_SYS; TestPoint_Keystone_5000-5004_Miniature
ADD ONS: Add-ons; PinHeader_1x07_P2.54mm_Vertical
AKKU: Akku_pins; JST_EH_B2B-EH-A_1x02_P2.50mm_Vertical
AKKU_MOT: AKKU_MOT; TestPoint_Keystone_5000-5004_Miniature
B_LED: Blue_LED; JST_PH_B2B-PH-K_1x02_P2.00mm_Vertical
C1: 22u; C_0805_2012Metric
C2: 4.7u; C_0805_2012Metric
C3, C10: 10u; C_0603_1608Metric
C4, C5, C6, C7, C8, C13, C14: 100nf; C_0402_1005Metric
C9: 100n; C_0603_1608Metric
C11, C12: 1u; C_0402_1005Metric
C15: 100n; C_0805_2012Metric
C16, C17: 10p; C_0402_1005Metric
C18: 100u; CP_Radial_D6.3mm_P2.50mm
C19: 4.7u; C_0402_1005Metric
D1, D2: D_Schottky; D_SMA
D3: SB5H90; D_DO-201AD_P15.24mm_Horizontal
DBG_1: DBG_1; TestPoint_Keystone_5000-5004_Miniature
DBG_2: DBG_2; TestPoint_Keystone_5000-5004_Miniature
ENCODER: Encoder_pins; PinHeader_1x04_P2.54mm_Vertical
F1: Polyfuse; Fuse_Bourns_MF-RHT200
FB1: 120R; L_0603_1608Metric
GND: GND; TestPoint_Bridge_Pitch2.0mm_Drill0.7mm
G_LED: Green_LED; JST_PH_B2B-PH-K_1x02_P2.00mm_Vertical
H1, H2, H3, H4: MountingHole; MountingHole_2.2mm_M2
IMU: IMU_pins; JST_PH_B6B-PH-K_1x06_P2.00mm_Vertical
J13: USB_B_Micro; USB_Micro-B_Wuerth_629105150521
LASER: Laser_pins; JST_PH_B2B-PH-K_1x02_P2.00mm_Vertical
POWER TASTER: PowerTaster_pins; JST_EH_B2B-EH-A_1x02_P2.50mm_Vertical
Q1: AO3400A; SOT-23
R1, R5, R7: 10k; R_0402_1005Metric
R2, R3, R4: 330; R_0402_1005Metric
R6: 39k; R_0402_1005Metric
R8, R9, R12, R13: 4k7; R_Axial_DIN0207_L6.3mm_D2.5mm_P7.62mm_Horizontal
R10: 100; R_0402_1005Metric
R11: 100k; R_0402_1005Metric
R14: 1k5; R_0402_1005Metric
R_LED: Red_LED; JST_PH_B2B-PH-K_1x02_P2.00mm_Vertical
SCL: I2C1_SCL; TestPoint_Keystone_5000-5004_Miniature
SCL#2: I2C2_SCL; TestPoint_Keystone_5000-5004_Miniature
SDA: I2C2_SDA; TestPoint_Keystone_5000-5004_Miniature
SDA#2: I2C1_SDA; TestPoint_Keystone_5000-5004_Miniature
SW1: SW_SPDT; SW_SPDT_PCM12
SWD: SWD_pins; PinHeader_1x05_P2.00mm_Vertical
TASTER: Taster; JST_PH_B2B-PH-K_1x02_P2.00mm_Vertical
TOF: ToF_pins; JST_PH_B5B-PH-K_1x05_P2.00mm_Vertical
TP1: +5V; TestPoint_Keystone_5000-5004_Miniature
TP4: +VDC; TestPoint_Keystone_5000-5004_Miniature
TP16, TP17: GND; TestPoint_Bridge_Pitch2.0mm_Drill0.7mm
U1: STM32F446RET6; LQFP-64_10x10mm_P0.5mm
U2: USB-C BMS Li-on Batterie Lademodul; USB-C BMS Li-on Batterie Lademodul 3S 4.5V-15V 18W 3A
U3: Waveshare DC-DC Buck Mini Module; WAVESHARE_DC_DC_CONVERTER
U4: LDO40LPU33RY; DFN-6-1EP_3x3mm_P0.95mm_EP1.7x2.6mm
U6: SIMPLEFOCMINI BRUSHLESS DC MOTOR - DRI0058
Y1: 16MHz; Crystal_SMD_3225-4Pin_3.2x2.5mm

Connections:
+3V3: 3V3.1 (1_1), ADD ONS.2, C2.1, C3.1, C4.1, C5.1, C6.1, C7.1, C8.1, C12.1, ENCODER.1, FB1.2, IMU.1, R1.2, R2.2, R8.2, R9.2, R12.2, R13.2, R14.1, SW1.3 (C), SWD.1, TOF.5, U1.1 (VBAT), U1.19 (VDD), U1.32 (VDD), U1.48 (VDD), U1.64 (VDD), U4.4 (Vout), U4.5 (Vsense)
+3V3A: 3V3A.1 (1_1), C9.1, C10.1, C11.1, FB1.1, U1.13 (VDDA)
+5V: D2.2 (A), LASER.1, TP1.1 (1_1), U3.5 (VOUT)
+VDC: ADD ONS.1, C18.1, POWER TASTER.1, R6.2, TP4.1 (1_1), U3.1 (VIN), U6.11 (VCC)
/+5_SYS: 5_SYS.1 (1_1), C1.1, D1.1 (K), D2.1 (K), U4.2 (EN), U4.3 (Vin)
/AKKU_MOT: AKKU_MOT.1 (1_1), C15.1, R6.1, R7.2, U1.9 (PC1/ADC2_IN11)
/BAT+: AKKU.1, F1.1
/DBG_1: DBG_1.1 (1_1), U1.35 (PB14)
/DBG_2: DBG_2.1 (1_1), U1.34 (PB13)
/DRIVER_EN: U1.39 (PC8), U6.5 (EN)
/DRIVER_FAULT: U1.36 (PB15), U6.10 (FAULT)
/DRIVER_IN1: U1.41 (PA8/TIM1_CH1), U6.2 (IN1)
/DRIVER_IN2: U1.42 (PA9/TIM1_CH2), U6.3 (IN2)
/DRIVER_IN3: U1.43 (PA10/TIM1_CH3), U6.4 (IN3)
/DRIVER_RESET: U1.38 (PC7), U6.8 (RESET)
/DRIVER_SLEEP: U1.37 (PC6), U6.9 (SLEEP)
/HSE_IN: C16.1, U1.5 (PH0), Y1.1
/HSE_OUT: C17.1, U1.6 (PH1), Y1.3
/I2C1_SCL: IMU.2, R12.1, SCL.1 (1_1), TOF.4, U1.58 (PB6/I2C1_SCL)
/I2C1_SDA: IMU.3, R13.1, SDA#2.1 (1_1), TOF.3, U1.59 (PB7/I2C1_SDA)
/I2C2_SCL: ADD ONS.5, ENCODER.2, R8.1, SCL#2.1 (1_1), U1.29 (PB10/I2C2_SCL)
/I2C2_SDA: ADD ONS.4, ENCODER.3, R9.1, SDA.1 (1_1), U1.53 (I2C2_SDA/PC12)
/IMU_INT: IMU.5, U1.56 (PB4)
/IMU_RST: IMU.4, U1.57 (PB5)
/LASER: R10.2, U1.26 (PB0)
/LASER-: LASER.2, Q1.3 (D)
/LED_BLUE: R3.2, U1.50 (PA15)
/LED_RED: R4.2, U1.40 (PC9)
/NRST: C14.1, SWD.5, U1.7 (NRST)
/RX: ADD ONS.6, U1.17 (PA37USART2_RX)
/SWCLK: SWD.2, U1.49 (PA14/SYS_JTCK_SWCLK)
/SWDIO: SWD.4, U1.46 (PA13/SYS-JTMS-SWDIO)
/SW_BOOT0: R5.2, SW1.2 (B)
/TASTER: C13.1, R1.1, TASTER.1, U1.14 (PA0)
/TX: ADD ONS.7, U1.16 (PA2/USART2_TX)
/USB_D+: J13.3 (D+), R14.2, U1.45 (PA12/USB_OTG_FS_DP)
/USB_D-: J13.2 (D-), U1.44 (PA11/USB_OTG_FS_DM)
GND: ADD ONS.3, AKKU.2, B_LED.2, C1.2, C2.2, C3.2, C4.2, C5.2, C6.2, C7.2, C8.2, C9.2, C10.2, C11.2, C12.2, C13.2, C14.2, C15.2, C16.2, C17.2, C18.2, C19.2, D3.2 (A), ENCODER.4, GND.1 (1_1), G_LED.2, IMU.6, J13.5 (GND), Q1.2 (S), R7.1, R11.2, R_LED.2, SW1.1 (A), SWD.3, TASTER.2, TOF.1, TOF.2, TP16.1 (1_1), TP17.1 (1_1), U1.12 (VSSA), U1.18 (VSS), U1.31 (VSS), U1.47 (VSS), U1.63 (VSS), U2.2 (B-), U3.3 (GND), U3.7 (VOUT), U4.1 (GND), U4.7 (GND), U6.1 (GND), U6.7 (GND), U6.12 (GND), Y1.2 (G), Y1.4 (G)
unnamed: D3.1 (K), F1.2, POWER TASTER.2, U2.1 (B+)
unnamed: G_LED.1, R2.1
unnamed: B_LED.1, R3.1
unnamed: R4.1, R_LED.1
unnamed: Q1.1 (G), R10.1, R11.1
unnamed: R5.1, U1.60 (BOOT0)
unnamed: C19.1, U1.30 (VCAP_1)
VBUS: D1.2 (A), J13.1 (VBUS)
