elektrowizards/Virtueller_Sicherheitsbereich_fuer_Fahrradfahrer/firmware_BA-testing_with laser driver/firmware/src/app/CalibrationStorage.h

#pragma once
#include <Arduino.h>

class CalibrationStorage {
public:
    bool saveHeight(float heightM);
    bool loadHeight(float& heightM);

private:
    struct Data {
        uint32_t magic;
        uint32_t version;
        float heightM;
        uint32_t checksum;
    };

    static uint32_t calculateChecksum(const Data& data);
};
