elektrowizards/Virtueller_Sicherheitsbereich_fuer_Fahrradfahrer/firmware_BA-testing_with laser driver/firmware/src/control/Geometry.h

#pragma once

namespace Geometry {
    float nominalAngleRad(float heightM);

    float motorTargetRad(
        float alignedMotorRad,
        float heightM,
        float relativeRollRad
    );

    float radToDeg(float radians);
    float degToRad(float degrees);
}
