elektrowizards/Virtueller_Sicherheitsbereich_fuer_Fahrradfahrer/(commit log)

2026-11-01 ready für bestellung
    [PCB_STM32_custom_board.kicad_pcb, PCB_STM32_custom_board.kicad_sch]
2026-11-11 ALIGN: stored mechanical reference, absolute roll, automatic homing to theta0
    - CalibrationStorage v2: stores the AS5600 RAW single-turn angle at which
    the beam is horizontal relative to the housing, the IMU mount offset and
    the reference distance. v1 (height) data is detected and treated as
    "no reference". Saving fills the EEPROM buffer and flushes once (the
    stm32duino EEPROM.put() erased the flash sector once per byte); the
    motor is switched off before the blocking flash write.
    - The reference lives in the raw encoder frame. After every initFOC() the
    shaft offset is rebuilt from one consistent (shaft, raw) sample and the
    detected sensor_direction, so turn counting and directi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
2026-11-11 RUN: hold the line distance on the ground instead of the beam angle
    In RUN the housing beam angle now follows alpha = theta(phi) - phi with
    theta(phi) = atan2(p + r_up*cos(phi) - r_out*sin(phi),
    D - r_out*cos(phi) - r_up*sin(phi)),
    so the line stays at TARGET_DISTANCE_M while the laser moves with the
    lean about the pivot. The ALIGN fine trim is kept as a world-angle
    offset. RUN_HOLD_DISTANCE = false restores the pure gimbal (beam angle
    hold) for A/B comparison on the bench. Travel and roll fault checks are
    unchanged.
    Claude-Session: https://claude.ai/code/session_012CTMf4Tv2e6XQCMuNPuFUc
2026-11-11 local work : laser driver, test, PCB reorganisation
    [629105150521 (rev1).stp, BOM_finale.csv, BOM_finale.xlsx, DC5-36-TO-DC3V3-5.PcbLib, Download_IGES_629105150521 (rev1).iges, Gehäuse-Body.3mf, Gehäuse-cap.3mf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]
2026-11-11 Button: short press in IDLE fires on release, report every button event
    In IDLE the short press was only reported 350 ms after release (double
    press window). A second press inside that window turned it into a double
    press, and IDLE silently ignored double and long presses, so the button
    seemed to do nothing. IDLE has no double-press function, so it now uses
    the immediate short press like RUN/CALIBRATION. Every button event is
    printed with the current state, and ignored events say what to do
    instead. The button mapping itself is unchanged.
    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
    [StateMachine.cpp]
2026-11-11 Homing: fix ramp/timeout clock after initFOC, wider start margin, guard 'z'
    - The loop's 'now' is sampled before finishCalibration() runs the
    blocking initFOC(), so homingStartMs_/lastRampMs_ (set from millis()
    inside it) were ahead of the next 'now'. The unsigned difference
    wrapped: the first ramp step skipped the slew limit and the timeout
    check fired at once, so homing from any position away from the goal
    would have faulted ("HOMED in 4294967264 ms" on the bench). The clocks
    now start on the first updateAlignTarget() call; dt is clamped >= 0.
    - HOMING_START_MARGIN_DEG 10 -> 45: the beam was found at -103 deg
    (past straight up) on the bench and homing was refused although the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
    [StateMachine.cpp, StateMachine.h, config.h]
